Poulperino/KRTEK_V2/POWER_BOARD/POWER_BOARD.pdf

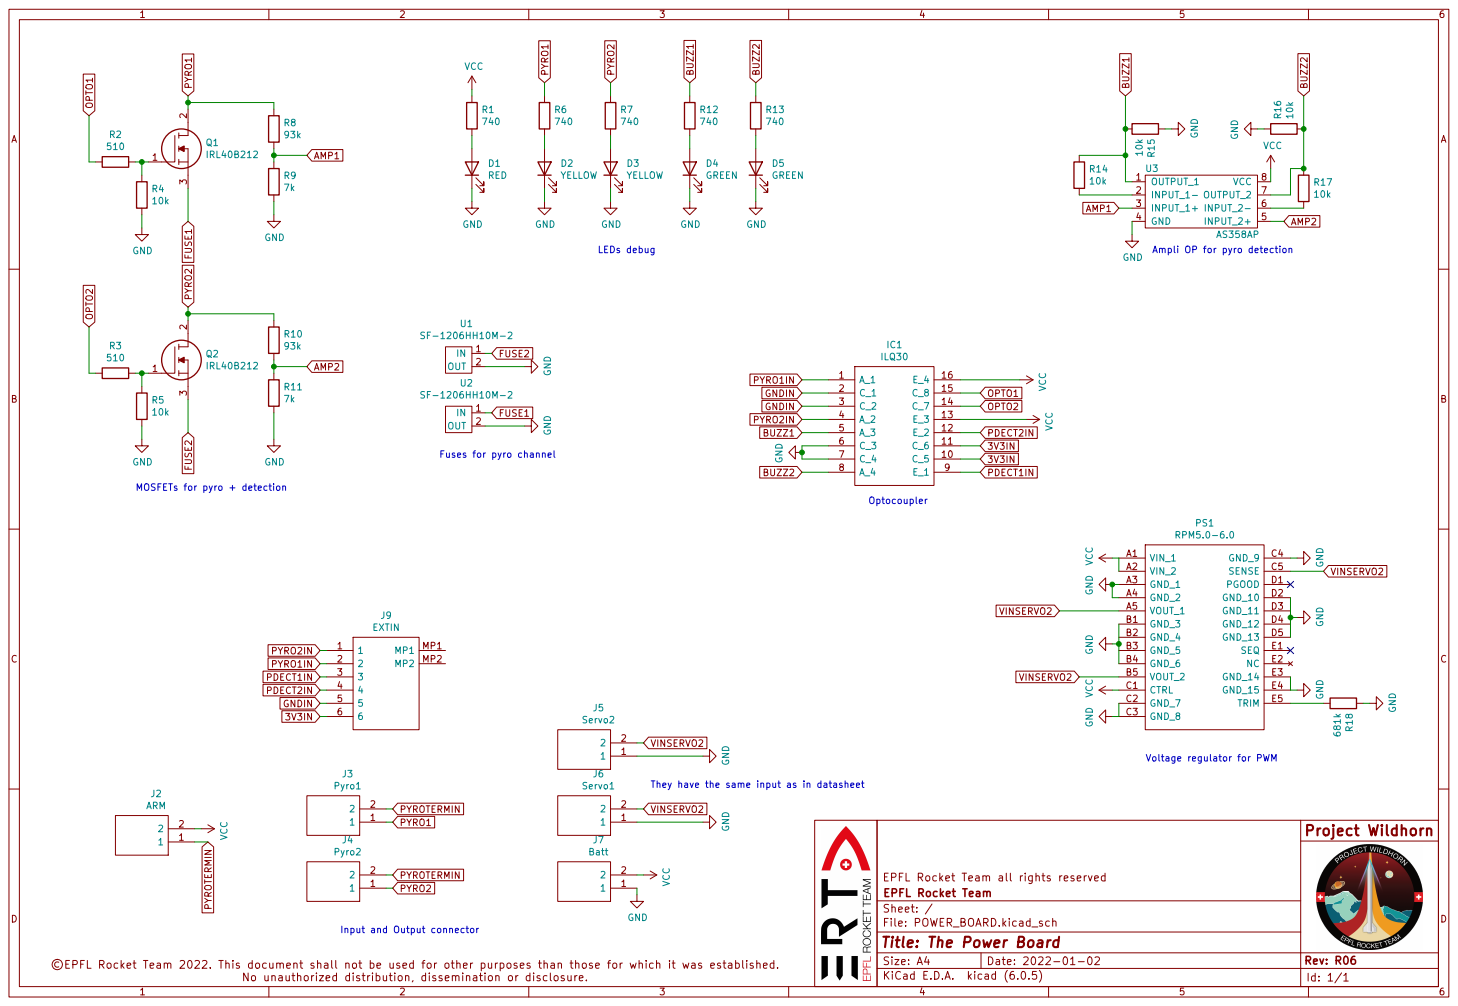
[picture p1: page 1]

VCC GND GND VCC GND

Ampli OP for pyro detection

Fuses for pyro channel

MOSFETs for pyro + detection

Voltage regulator for PWM

EPFL Rocket Team all rights reserved
File: POWER_BOARD.kicad_sch Sheet: / EPFL Rocket Team

Id: 1/1 Title: The Power Board

Input and Output connector
