Poulperino/KRTEK_V2/POWER_BOARD/POWER_BOARD.kicad_pcb

## KiCad design POWER_BOARD/POWER_BOARD.kicad_pcb (2022-11-03)

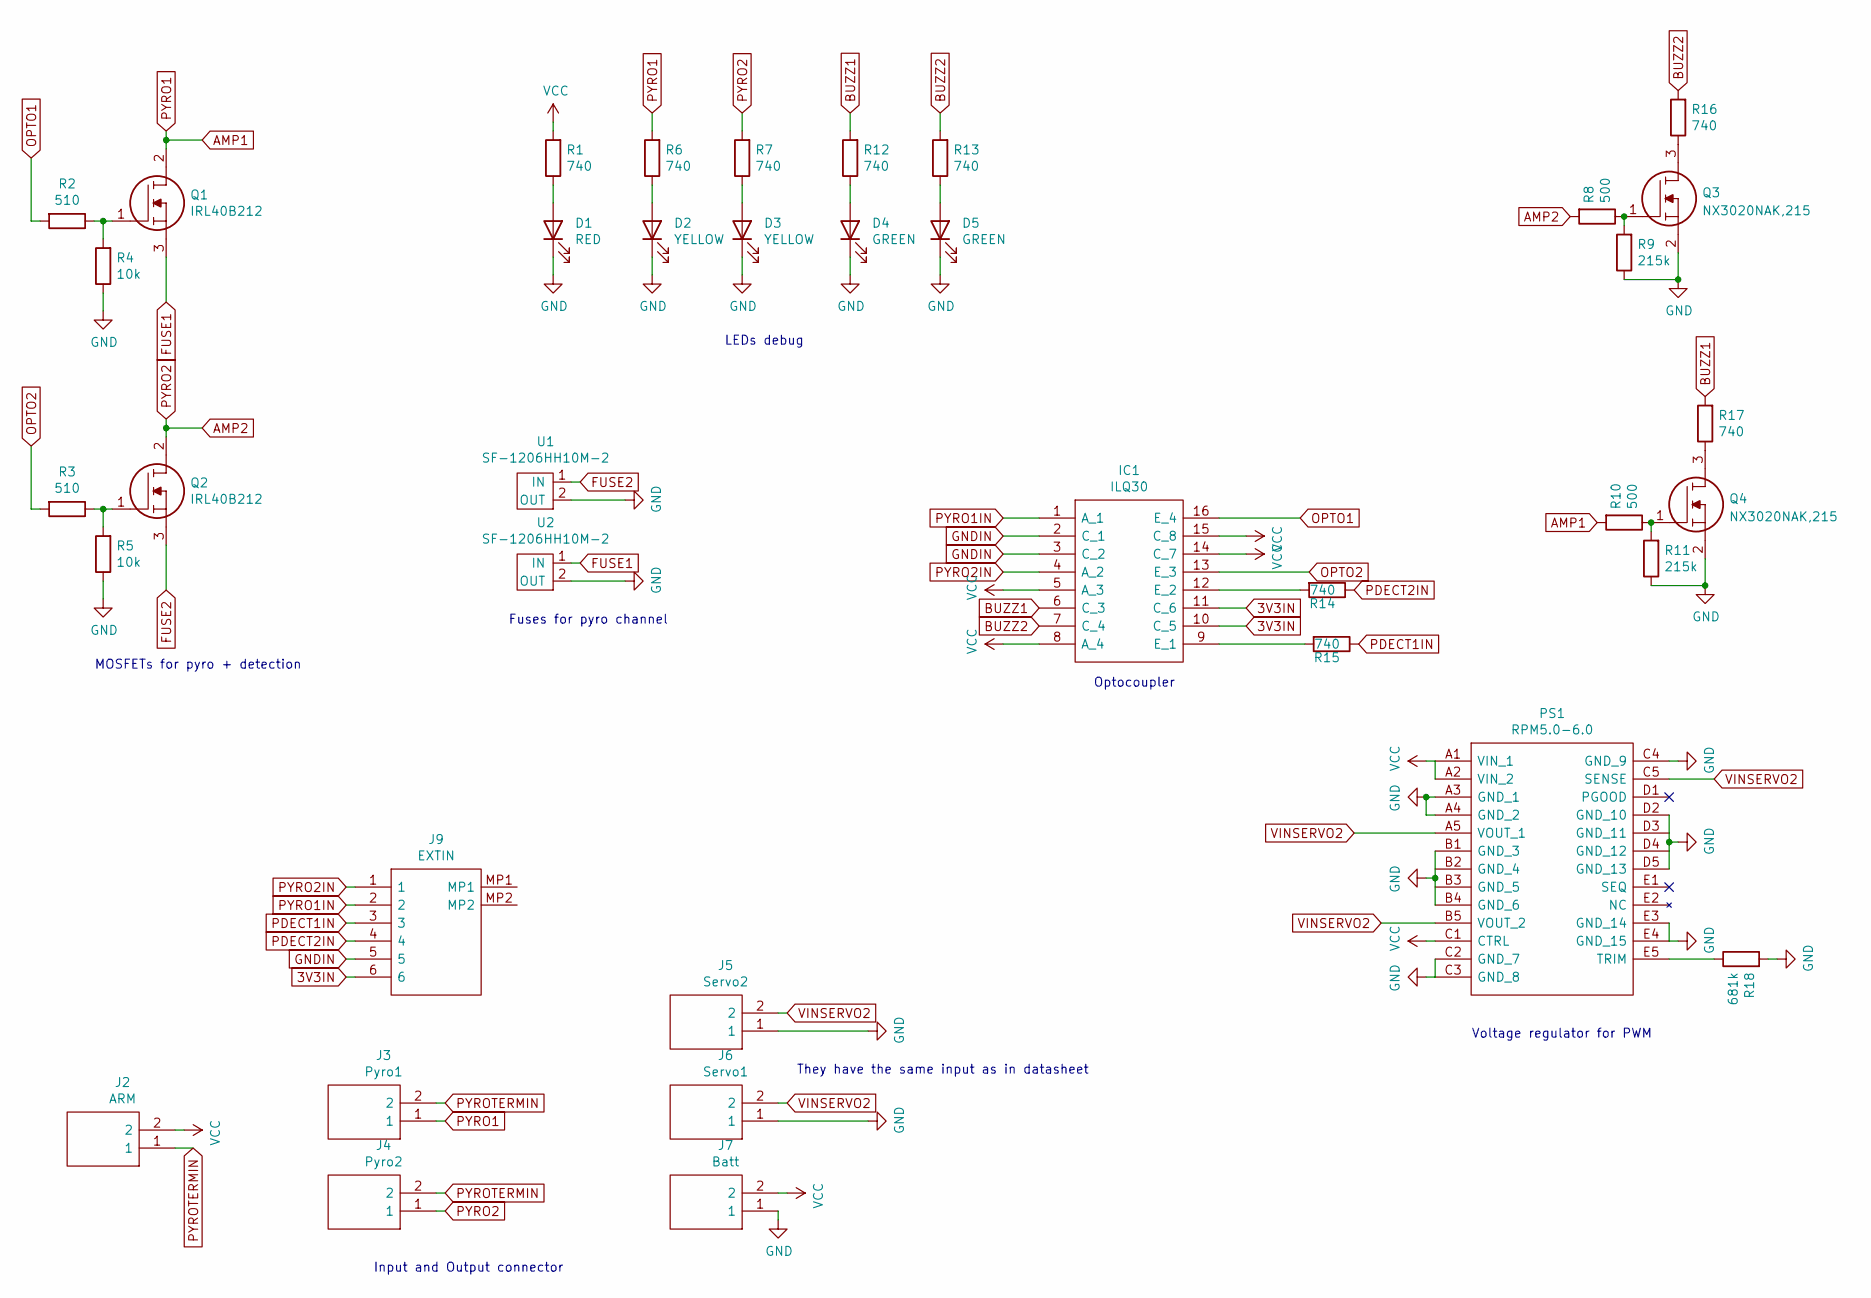
[picture p2: schematic POWER_BOARD.kicad_sch, The Power Board]

Parts:
D1: RED; LED_2-SMD_No_Lead_1.7x0.8mm
D2, D3: YELLOW; LED_2-SMD_No_Lead_1.7x0.8mm
D4, D5: GREEN; LED_2-SMD_No_Lead_1.7x0.8mm
IC1: ILQ30; DIP762W60P254L2030H430Q16N; Mouser Part Number 782-ILQ30
J2: ARM; 282834-2_1; Mouser Part Number 571-282834-2
J3: Pyro1; 282834-2_1; Mouser Part Number 571-282834-2
J4: Pyro2; 282834-2_1; Mouser Part Number 571-282834-2
J5: Servo2; 282834-2_1; Mouser Part Number 571-282834-2
J6: Servo1; 282834-2_1; Mouser Part Number 571-282834-2
J7: Batt; 282834-2_1; Mouser Part Number 571-282834-2
J9: EXTIN; 5055670671; Mouser Part Number 538-505567-0671
PS1: RPM5.0-6.0; RPM5060; Mouser Part Number 919-RPM5.0-6.0
Q1, Q2: IRL40B212; TO254P483X1016X1994-3P; Mouser Part Number 942-IRL40B212
Q3, Q4: NX3020NAK,215; SOT-23; Mouser Part Number 942-IRL40B212
R1, R6, R7, R12, R13, R14, R15, R16, R17: 740; R_0603_1608Metric
R2, R3: 510; R_0603_1608Metric
R4, R5: 10k; R_0603_1608Metric
R8, R10: 500; R_0603_1608Metric
R9, R11: 215k; R_0603_1608Metric
R18: 681k; R_0603_1608Metric
U1, U2: SF-1206HH10M-2

Connections:
3V3IN: IC1.10 (C_5), IC1.11 (C_6), J9.6
AMP1: J3.1, Q1.2, R6.2, R10.2
AMP2: J4.1, Q2.2, R7.2, R8.2
BUZZ1: IC1.6 (C_3), R12.2, R17.2
BUZZ2: IC1.7 (C_4), R13.2, R16.2
FUSE1: Q1.3, U2.1 (IN)
FUSE2: Q2.3, U1.1 (IN)
GND: D1.1 (K), D2.1 (K), D3.1 (K), D4.1 (K), D5.1 (K), J5.1, J6.1, J7.1, PS1.A3 (GND_1), PS1.A4 (GND_2), PS1.B1 (GND_3), PS1.B4 (GND_6), PS1.C2 (GND_7), PS1.C3 (GND_8), PS1.C4 (GND_9), PS1.D2 (GND_10), PS1.D5 (GND_13), PS1.E3 (GND_14), PS1.E4 (GND_15), Q3.2, Q4.2, R4.1, R5.1, R9.1, R11.1, R18.2, U1.2 (OUT), U2.2 (OUT)
GNDIN: IC1.2 (C_1), IC1.3 (C_2), J9.5
unnamed: D1.2 (A), R1.1
unnamed: D2.2 (A), R6.1
unnamed: D3.2 (A), R7.1
unnamed: D4.2 (A), R12.1
unnamed: D5.2 (A), R13.1
unnamed: IC1.9 (E_1), R15.2
unnamed: IC1.12 (E_2), R14.2
unnamed: PS1.E5 (TRIM), R18.1
unnamed: Q1.1, R2.1, R4.2
unnamed: Q2.1, R3.1, R5.2
unnamed: Q3.1, R8.1, R9.2
unnamed: Q3.3, R16.1
unnamed: Q4.1, R10.1, R11.2
unnamed: Q4.3, R17.1
OPTO1: IC1.16 (E_4), R2.2
OPTO2: IC1.13 (E_3), R3.2
PDECT1IN: J9.3, R15.1
PDECT2IN: J9.4, R14.1
PYRO1IN: IC1.1 (A_1), J9.2
PYRO2IN: IC1.4 (A_2), J9.1
PYROTERMIN: J2.1, J3.2, J4.2
VCC: IC1.5 (A_3), IC1.8 (A_4), IC1.14 (C_7), IC1.15 (C_8), J2.2, J7.2, PS1.A1 (VIN_1), PS1.A2 (VIN_2), PS1.C1 (CTRL), R1.2
VINSERVO2: J5.2, J6.2, PS1.A5 (VOUT_1), PS1.B5 (VOUT_2), PS1.C5 (SENSE)

Notes on the sheet:
MOSFETs for pyro + detection
Input and Output connector
LEDs debug
Fuses for pyro channel
Optocoupler
Voltage regulator for PWM
They have the same input as in datasheet

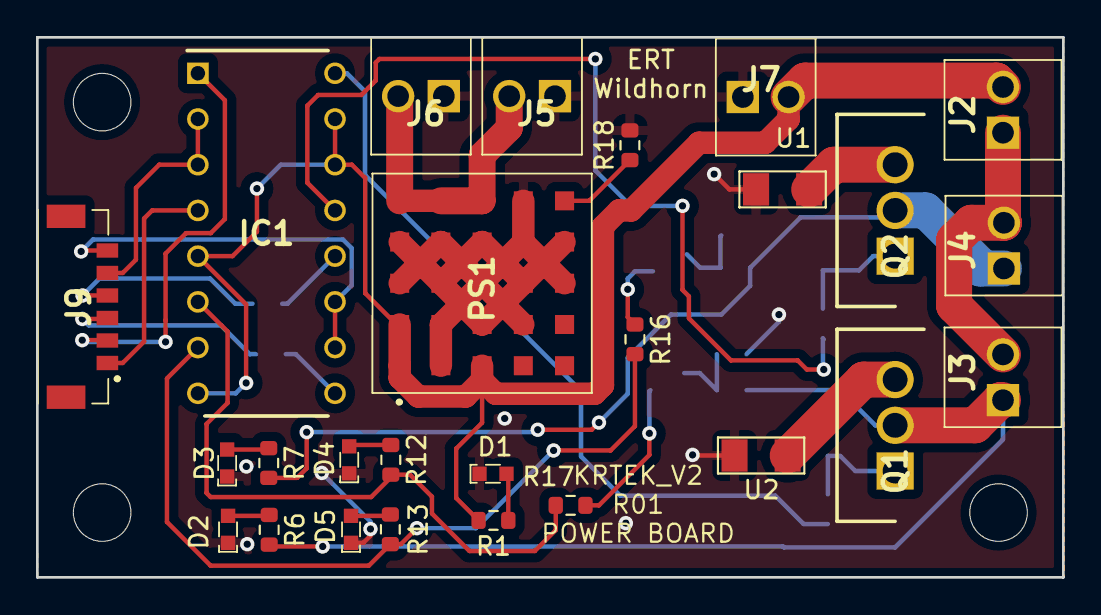
[picture p3: board POWER_BOARD.kicad_pcb from above]

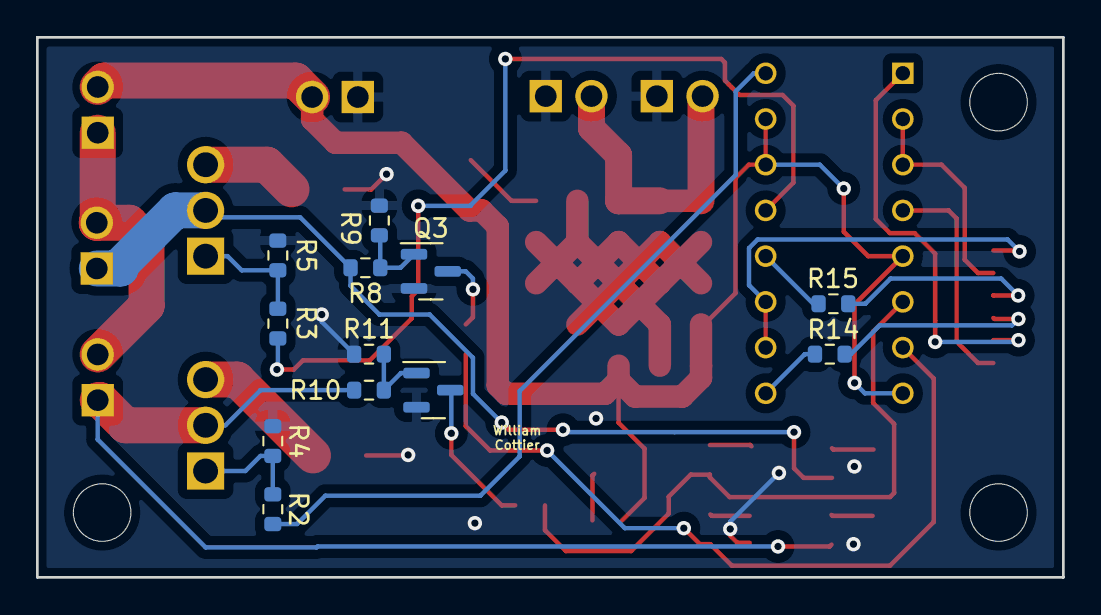
[picture p4: board POWER_BOARD.kicad_pcb from below]

Board: 2 copper layers, 57.0 x 30.0 mm, 38 parts (12 on the bottom side), 32 nets.
