Poulperino/KRTEK_V2/EXTENSION_BOARD/EXTENSION_BOARD.kicad_pcb

## KiCad design EXTENSION_BOARD/EXTENSION_BOARD.kicad_pcb (2022-11-03)

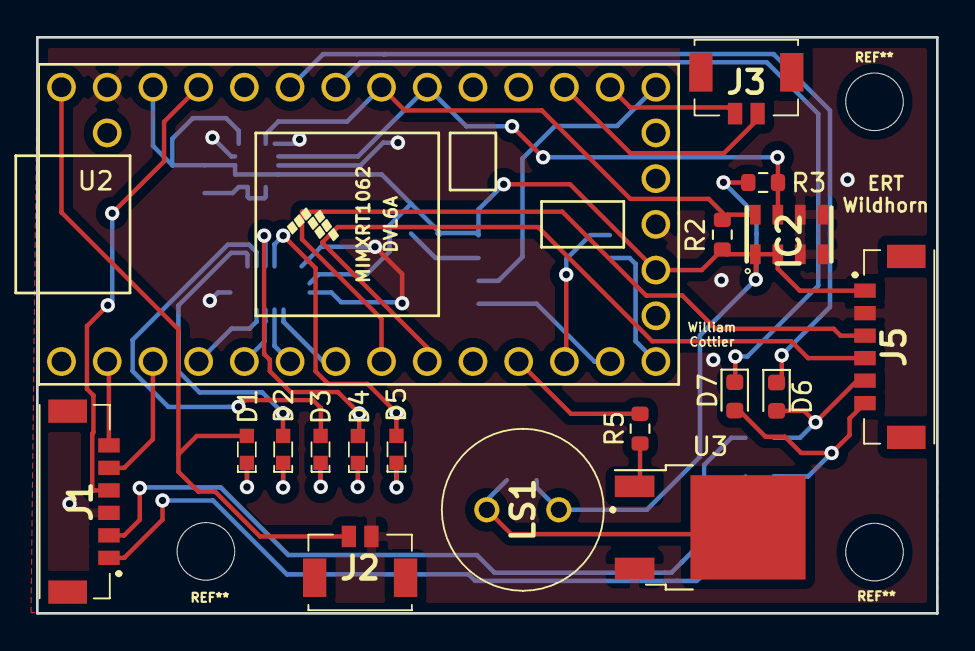
[picture p5: board EXTENSION_BOARD.kicad_pcb from above]

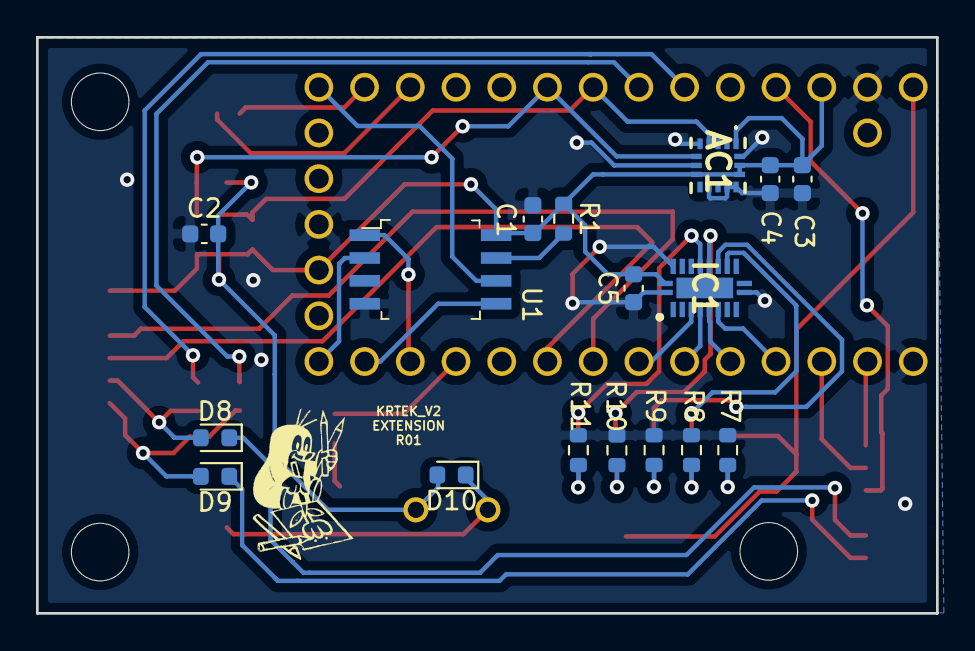
[picture p6: board EXTENSION_BOARD.kicad_pcb from below]

Board: 2 copper layers, 50.0 x 32.0 mm, 35 parts (17 on the bottom side), 39 nets.

Parts:
AC1: Accel - H3LIS331DLTR; LIS3DHTR
C1: 100nF; C_0603_1608Metric
C2, C3, C5: 0.1uF; C_0603_1608Metric
C4: 10uF; C_0603_1608Metric
D1: RED; LED_2-SMD_No_Lead_1.7x0.8mm
D2, D3: YELLOW; LED_2-SMD_No_Lead_1.7x0.8mm
D4, D5: GREEN; LED_2-SMD_No_Lead_1.7x0.8mm
D6, D7, D8, D9, D10: DIODE; D_0603_1608Metric
IC1: TeensyBuffer - 74AHCV541ABQX; QFN50P250X450X100-21N-D
IC2: Baro - MS561101BA03-50; MS561101BA03-50
J1: EXTIN; 5055670671
J2: BATT; 5055670281
J3: PWM; 5055670281
J5: EXTOUT; 5055670671
LS1: Buzzer - CST-931AP; CST931AP
R1: 10M; R_0603_1608Metric
R2, R3: 3.3K; R_0603_1608Metric
R5: 10k; R_0603_1608Metric
R7: 500; R_0603_1608Metric
R8, R9, R10, R11: 330; R_0603_1608Metric
U1: Flash - COM-15809; SOIC-8_W5.6mm
U2: Teensy4.0; Teensy40_EXT
U3: MJD148J; TO-252-2

Connections:
+3V3: AC1.1, AC1.8, AC1.14, AC1.15, C1.1, C2.2, C3.1, C4.1, C5.2, D10.2, IC1.20, IC2.1, IC2.2, J5.1, LS1.1, R1.1, R2.2, R3.2, U1.8, U2.16, U2.31
Accel_SCL: AC1.4, IC2.8, R2.1, U2.26
Accel_SDA: AC1.6, IC2.7, R3.1, U2.25
Buzzer: D10.1, LS1.2, U3.2
CS_FLASH: U1.1, U2.12
GLED1: D4.2, IC1.15
GLED2: D5.2, IC1.16
GND: AC1.5, AC1.7, AC1.10, AC1.12, AC1.13, AC1.16, C1.2, C2.1, C3.2, C4.2, C5.1, IC1.1, IC1.10, IC1.19, IC2.3, IC2.4, IC2.5, IC2.6, J1.3, J2.2, J5.2, R7.1, R8.1, R9.1, R10.1, R11.1, U1.4, U2.1, U2.17, U2.32, U3.3
HFREE: J1.4, U2.30
HRX: J1.6, U2.2
HTX: J1.5, U2.3
MISO: U1.2, U2.14
MOSI: U1.5, U2.13
unnamed: D1.1, R7.2
unnamed: D2.1, R8.2
unnamed: D3.1, R9.2
unnamed: D4.1, R10.2
unnamed: D5.1, R11.2
unnamed: R1.2, U1.7
unnamed: R5.1, U3.1
OPYRO1: D6.2, D8.2, J5.5
OPYRO2: D7.2, D9.2, J5.6
PDECT1: J5.3, U2.8
PDECT2: J5.4, U2.9
PWM1: J3.2, U2.21
PWM2: J3.1, U2.22
PYRO1: D8.1, J1.2
PYRO2: D9.1, J1.1
SCLK: U1.6, U2.20
TBuzzer: R5.2, U2.11
TGLED1: IC1.5, U2.6
TGLED2: IC1.4, U2.7
TPyro1OUT: D6.1, U2.28
TPyro2OUT: D7.1, U2.27
TYLED1: IC1.7, U2.4
TYLED2: IC1.6, U2.5
VIN: D1.2, J2.1, U2.33
YLED1: D2.2, IC1.13
YLED2: D3.2, IC1.14
