Poulperino/KRTEK_V2/CLIP_HOSTBOARD/CLIP_HOSTBOARD.kicad_pcb

## KiCad design CLIP_HOSTBOARD/CLIP_HOSTBOARD.kicad_pcb (2021-12-23)

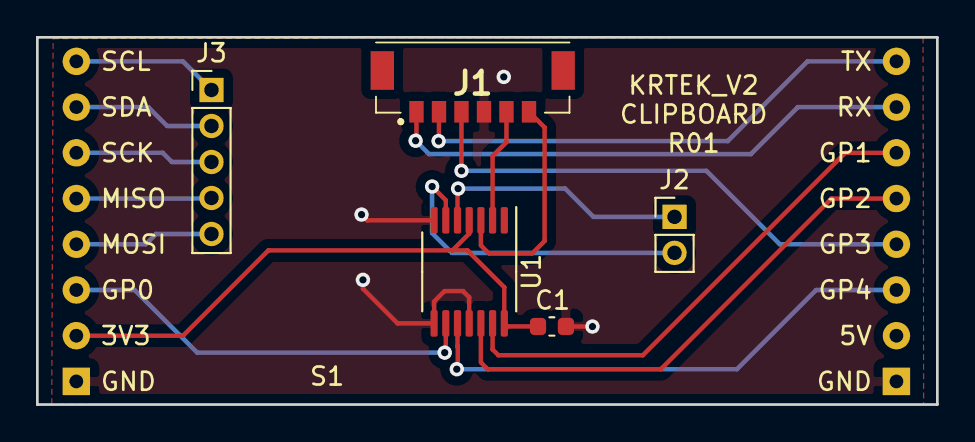
[picture p7: board CLIP_HOSTBOARD.kicad_pcb from above]

Board: 2 copper layers, 50.0 x 20.4 mm, 6 parts (0 on the bottom side), 18 nets.

Parts:
C1: 0.1uF; C_0603_1608Metric
J1: 505567-0671; 5055670671
J2: 1x2_header; PinHeader_1x02_P2.00mm_Vertical
J3: 1x5_header; PinHeader_1x05_P2.00mm_Vertical
S1: Socket; SOCKET
U1: Buffer; TSSOP-14_4.4x5mm_P0.65mm

Connections:
3V3: C1.2, S1.7, U1.4, U1.14
BFREEIN1: S1.11, U1.10
BFREEIN2: S1.6, U1.9
BFREEOUT1: J2.1, U1.5
BFREEOUT2: J2.2, U1.6
GND: C1.1, J1.4, S1.8, S1.9, U1.7, U1.8, U1.11
HFREE: J1.3, S1.12
HPYRO1: S1.14, U1.13
HPYRO2: S1.13, U1.12
HRX: J1.1, S1.15
HTX: J1.2, S1.16
MISOFREE: J3.4, S1.4
MOSIFREE: J3.5, S1.5
PYRO1: J1.5, U1.2
PYRO2: J1.6, U1.3
SCKFREE: J3.3, S1.3
SCLFREE: J3.1, S1.1
SDAFREE: J3.2, S1.2
