Poulperino/KRTEK_V2/POWER_BOARD/V05_POWER_BOARD.kicad_pcb

## KiCad design POWER_BOARD/V05_POWER_BOARD.kicad_pcb (2021-11-19)

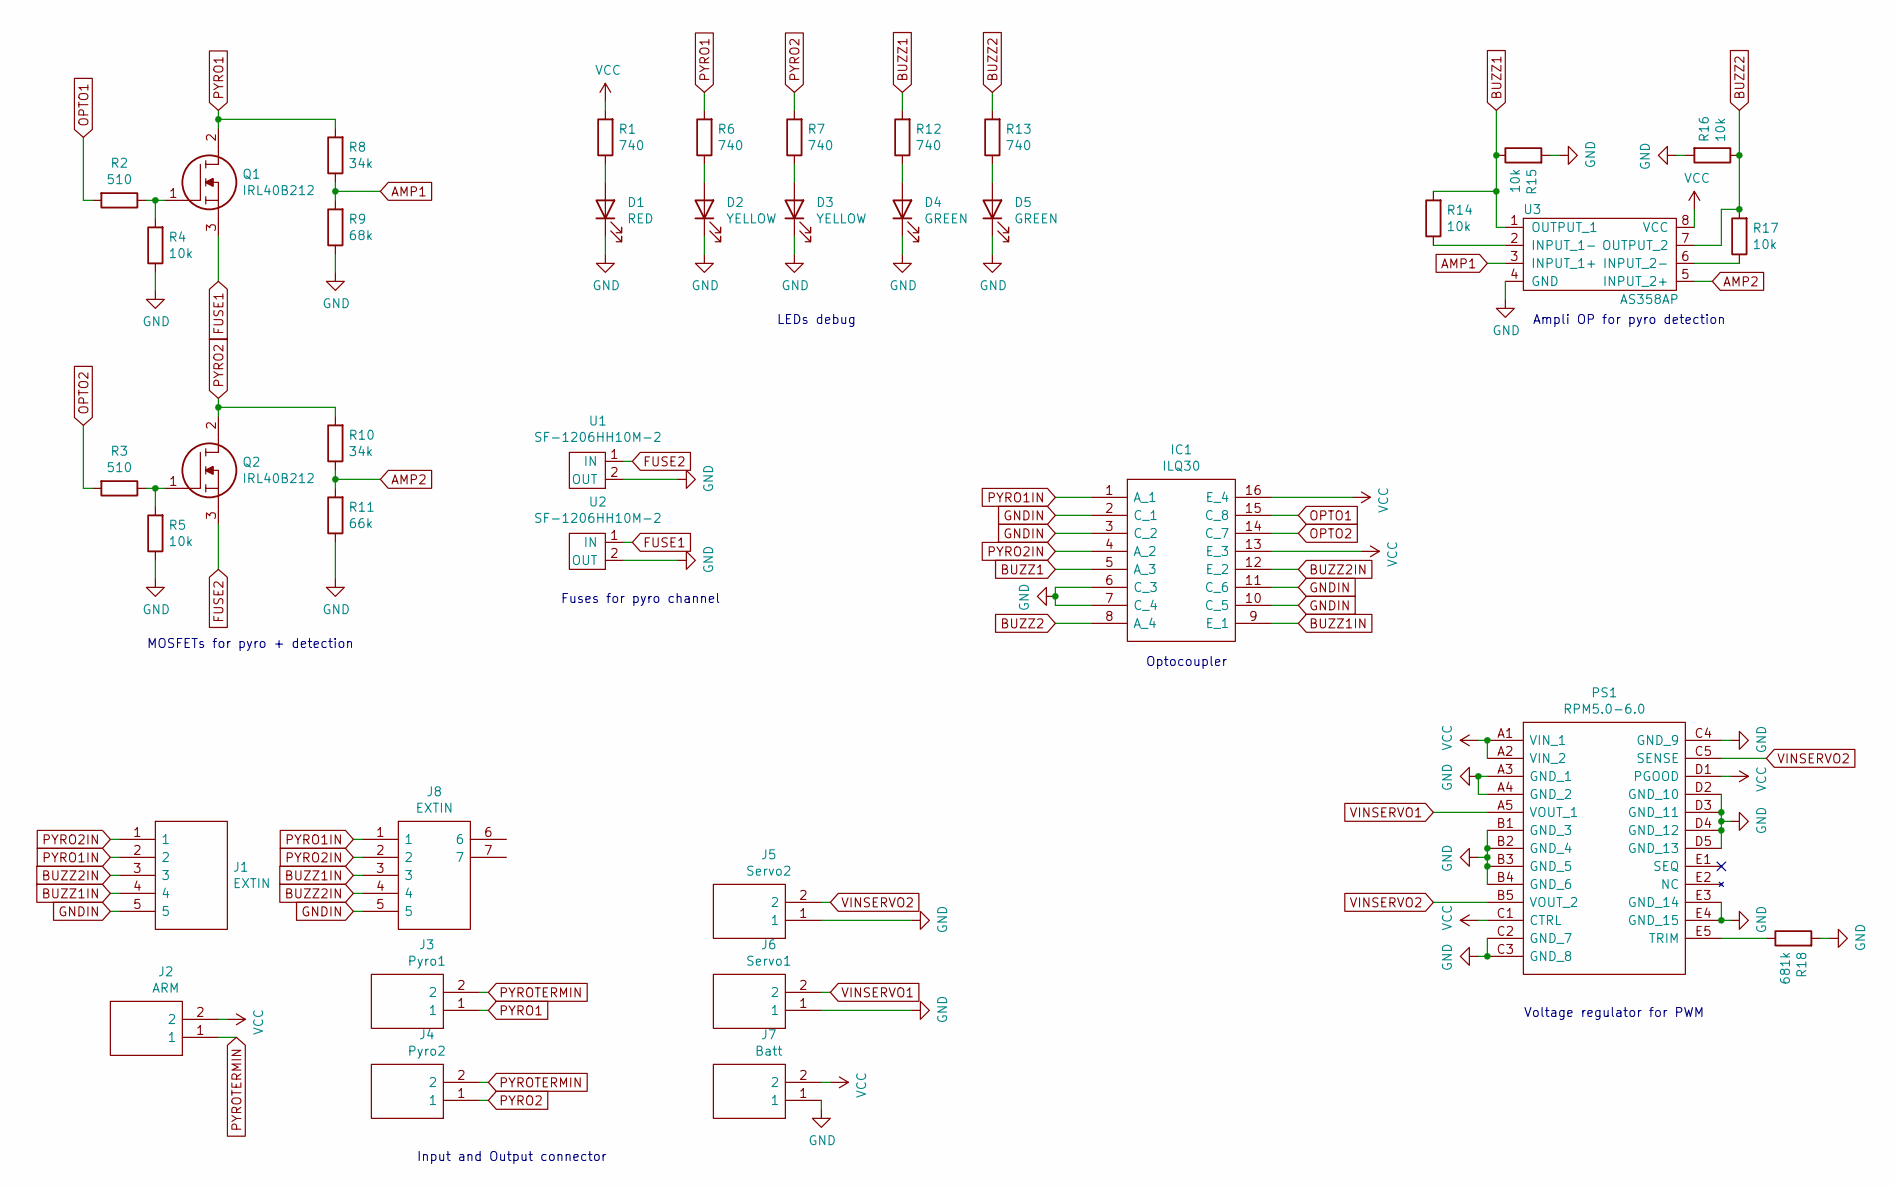
[picture p8: schematic V05_POWER_BOARD.sch]

Parts:
D1: RED; LED_2-SMD_No_Lead_1.7x0.8mm
D2, D3: YELLOW; LED_2-SMD_No_Lead_1.7x0.8mm
D4, D5: GREEN; LED_2-SMD_No_Lead_1.7x0.8mm
IC1: ILQ30; DIP762W60P254L2030H430Q16N; Mouser Part Number 782-ILQ30
J1: EXTIN; 2828345; Mouser Part Number 571-282834-5
J2: ARM; 282834-2_1; Mouser Part Number 571-282834-2
J3: Pyro1; 282834-2_1; Mouser Part Number 571-282834-2
J4: Pyro2; 282834-2_1; Mouser Part Number 571-282834-2
J5: Servo2; 282834-2_1; Mouser Part Number 571-282834-2
J6: Servo1; 282834-2_1; Mouser Part Number 571-282834-2
J7: Batt; 282834-2_1; Mouser Part Number 571-282834-2
J8: EXTIN; 5055670571; Mouser Part Number 538-505567-0571
PS1: RPM5.0-6.0; RPM5060; Mouser Part Number 919-RPM5.0-6.0
Q1, Q2: IRL40B212; TO254P483X1016X1994-3P; Mouser Part Number 942-IRL40B212
R1, R6, R7, R12, R13: 740; R_0603_1608Metric
R2, R3: 510; R_0603_1608Metric
R4, R5, R14, R15, R16, R17: 10k; R_0603_1608Metric
R8, R10: 34k; R_0603_1608Metric
R9: 68k; R_0603_1608Metric
R11: 66k; R_0603_1608Metric
R18: 681k; R_0603_1608Metric
U1, U2: SF-1206HH10M-2
U3: AS358AP; AS358AP-PDIP-8

Connections:
AMP1: R8.1, R9.2, U3.3 (INPUT_1+)
AMP2: R10.1, R11.2, U3.5 (INPUT_2+)
BUZZ1: IC1.5 (A_3), R12.2, R14.2, R15.1, U3.1 (OUTPUT_1)
BUZZ1IN: IC1.9 (E_1), J1.4, J8.3
BUZZ2: IC1.8 (A_4), R13.2, R16.1, R17.2, U3.7 (OUTPUT_2)
BUZZ2IN: IC1.12 (E_2), J1.3, J8.4
FUSE1: Q1.3, U2.1 (IN)
FUSE2: Q2.3, U1.1 (IN)
GND: D1.1 (K), D2.1 (K), D3.1 (K), D4.1 (K), D5.1 (K), IC1.6 (C_3), IC1.7 (C_4), J5.1, J6.1, J7.1, PS1.A3 (GND_1), PS1.A4 (GND_2), PS1.B1 (GND_3), PS1.B2 (GND_4), PS1.B3 (GND_5), PS1.B4 (GND_6), PS1.C2 (GND_7), PS1.C3 (GND_8), PS1.C4 (GND_9), PS1.D2 (GND_10), PS1.D3 (GND_11), PS1.D4 (GND_12), PS1.D5 (GND_13), PS1.E3 (GND_14), PS1.E4 (GND_15), R4.1, R5.1, R9.1, R11.1, R15.2, R16.2, R18.2, U1.2 (OUT), U2.2 (OUT), U3.4 (GND)
GNDIN: IC1.2 (C_1), IC1.3 (C_2), IC1.10 (C_5), IC1.11 (C_6), J1.5, J8.5
unnamed: D1.2 (A), R1.1
unnamed: D2.2 (A), R6.1
unnamed: D3.2 (A), R7.1
unnamed: D4.2 (A), R12.1
unnamed: D5.2 (A), R13.1
unnamed: PS1.E5 (TRIM), R18.1
unnamed: Q1.1, R2.1, R4.2
unnamed: Q2.1, R3.1, R5.2
unnamed: R14.1, U3.2 (INPUT_1-)
unnamed: R17.1, U3.6 (INPUT_2-)
OPTO1: IC1.15 (C_8), R2.2
OPTO2: IC1.14 (C_7), R3.2
PYRO1: J3.1, Q1.2, R6.2, R8.2
PYRO1IN: IC1.1 (A_1), J1.2, J8.1
PYRO2: J4.1, Q2.2, R7.2, R10.2
PYRO2IN: IC1.4 (A_2), J1.1, J8.2
PYROTERMIN: J2.1, J3.2, J4.2
VCC: IC1.13 (E_3), IC1.16 (E_4), J2.2, J7.2, PS1.A1 (VIN_1), PS1.A2 (VIN_2), PS1.C1 (CTRL), PS1.D1 (PGOOD), R1.2, U3.8 (VCC)
VINSERVO1: J6.2, PS1.A5 (VOUT_1)
VINSERVO2: J5.2, PS1.B5 (VOUT_2), PS1.C5 (SENSE)

Notes on the sheet:
LEDs debug
MOSFETs for pyro + detection
Fuses for pyro channel
Input and Output connector
Voltage regulator for PWM
Optocoupler
Ampli OP for pyro detection

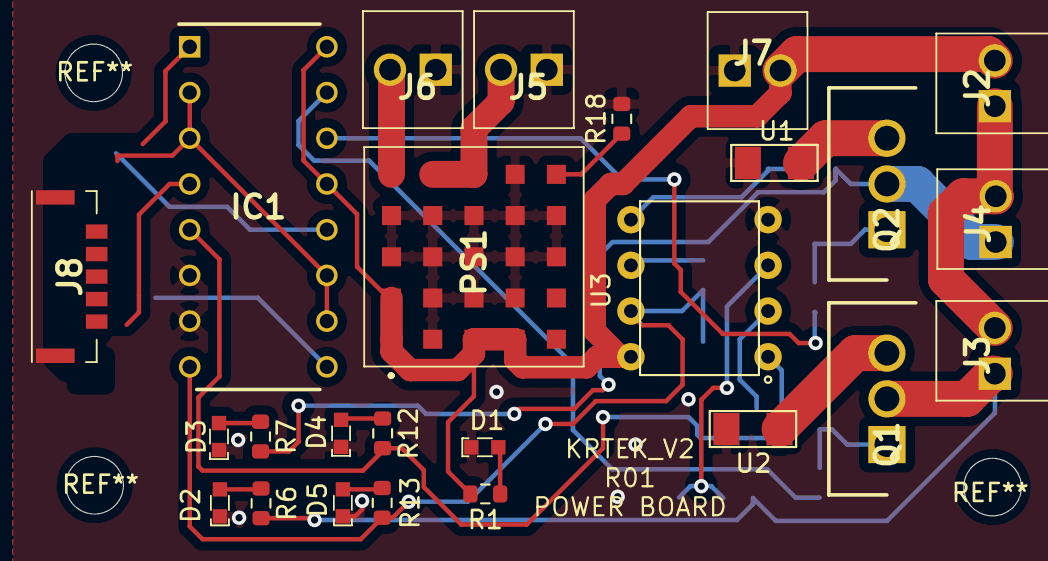
[picture p9: board V05_POWER_BOARD.kicad_pcb from above]

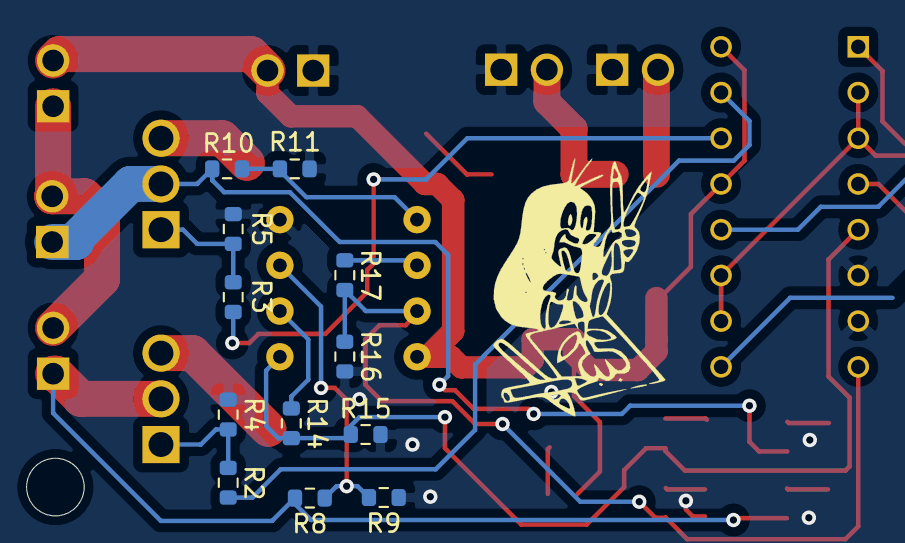
[picture p10: board V05_POWER_BOARD.kicad_pcb from below]

Board: 2 copper layers, 37 parts (12 on the bottom side), 30 nets.
