Poulperino/KRTEK_V2/EXTENSION_BOARD/V02_EXTENSION_BOARD.kicad_pcb

## KiCad design EXTENSION_BOARD/V02_EXTENSION_BOARD.kicad_pcb (2021-11-12, an earlier design)

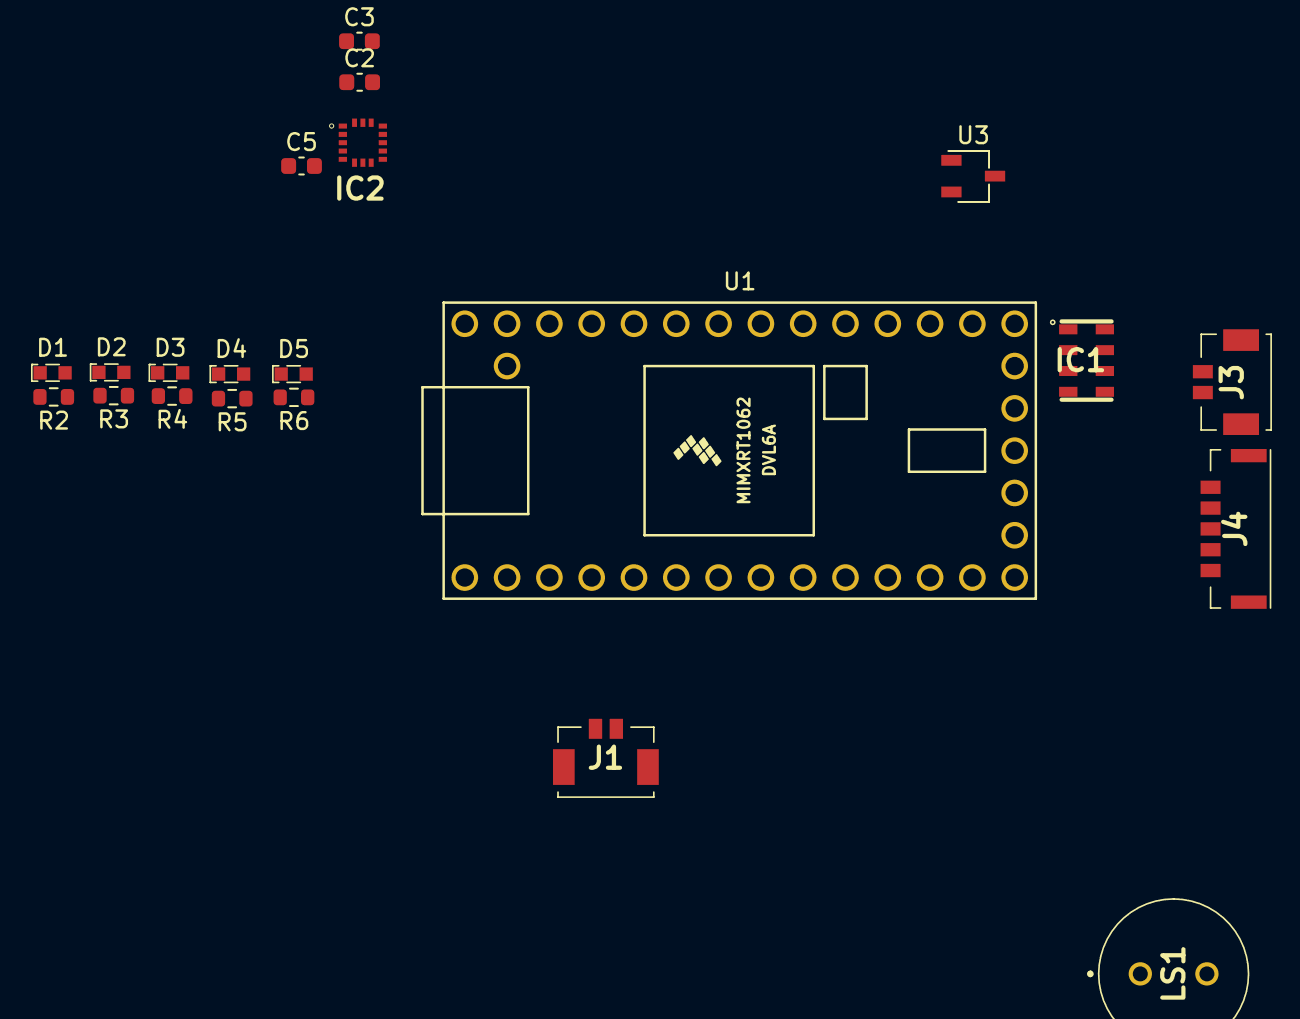
[picture p11: board V02_EXTENSION_BOARD.kicad_pcb from above]

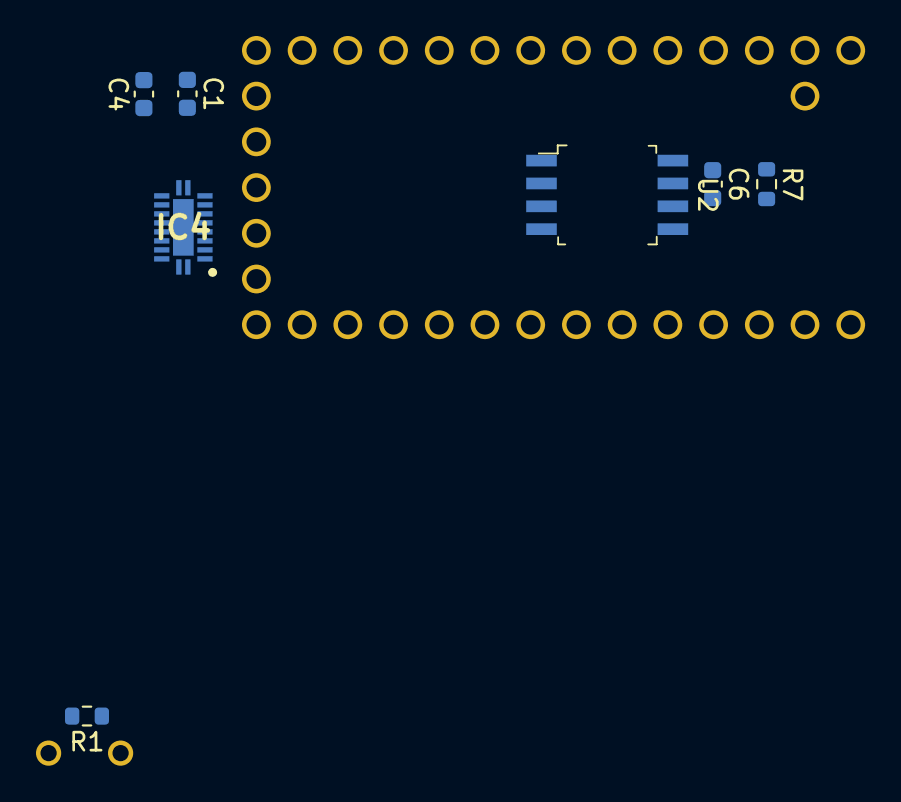
[picture p12: board V02_EXTENSION_BOARD.kicad_pcb from below]

Board: 2 copper layers, 28 parts (7 on the bottom side), 25 nets, no tracks yet.

Parts:
C1: 100nF; C_0603_1608Metric
C2: 0.1uF; C_0603_1608Metric
C3: 10nF; C_0603_1608Metric
C4: 2.2uF; C_0603_1608Metric
C5: 0.47uF; C_0603_1608Metric
C6: 22pF; C_0603_1608Metric
D1: RED; LED_2-SMD_No_Lead_1.7x0.8mm
D2, D3: YELLOW; LED_2-SMD_No_Lead_1.7x0.8mm
D4, D5: GREEN; LED_2-SMD_No_Lead_1.7x0.8mm
IC1: Baro; MS561101BA03-50
IC2: ICM-20608-G; PULL-BACK-QFN-16
IC4: TeensyBuffer; QFN50P250X450X100-21N-D
J1: BATT; 5055670281
J3: PWM; 5055670281
J4: EXTOUT; 5055670571
LS1: Buzzer; CST931AP
R1: 1k; R_0603_1608Metric
R2: 740; R_0603_1608Metric
R3, R4, R5, R6: 330; R_0603_1608Metric
R7: 10M; R_0603_1608Metric
U1: Teensy4.0; Teensy40_EXT
U2: COM-15809; SOIC-8_W5.6mm
U3: MOSBuzzer; TSOT-23

Connections:
3V3: C1.2, C2.1, C3.1, C4.1, C6.1, IC1.1, IC2.1, IC2.16, R7.1, U1.16, U1.31, U2.8, U3.3
BUZZ1: IC4.14, J4.3
BUZZ2: IC4.13, J4.4
Buzzer: LS1.1, R1.1, U3.2
GLED1: D4.2, IC4.16
GLED2: D5.2, IC4.15
GND: C1.1, C2.2, C3.2, C4.2, C5.1, C6.2, IC1.2, IC1.3, IC2.9, IC2.10, IC2.11, IC2.12, IC2.13, IC2.15, IC4.1, IC4.10, IC4.19, J1.1, J4.5, LS1.2, R1.2, R2.1, R3.1, R4.1, R5.1, R6.1, U1.1, U1.17, U1.32, U2.4
MISO: IC1.6, U2.2
MOSI: IC1.7, U2.5
unnamed: C5.2, IC2.14
unnamed: D1.1, R2.2
unnamed: D2.1, R3.2
unnamed: D3.1, R4.2
unnamed: D4.1, R5.2
unnamed: D5.1, R6.2
unnamed: R7.2, U2.7
SCLK: IC1.8, IC2.2, U2.6
TBuzzer: U1.8, U3.1
TGLED1: IC4.4, U1.6
TGLED2: IC4.5, U1.7
TYLED1: IC4.2, U1.4
TYLED2: IC4.3, U1.5
VIN: IC4.20, J1.2, U1.33
YLED1: D2.2, IC4.18
YLED2: D3.2, IC4.17
