Poulperino/KRTEK_V2/(commit log)

2021-11-09 Update POWER_BOARD.sch-bak
2021-11-09 Update EXTENSION_BOARD.kicad_pcb-bak
2021-11-15 Worked again
    [EXTENSION_BOARD.kicad_pcb, EXTENSION_BOARD.sch, POWER_BOARD.kicad_pcb, POWER_BOARD.sch, V03_EXTENSION_BOARD.kicad_pcb, V03_EXTENSION_BOARD.sch, V04_EXTENSION_BOARD.sch]
2021-11-19 Sent schematics to review
    [CLIP_HOSTBOARD.kicad_pcb, CLIP_HOSTBOARD.sch, EXTENSION_BOARD.kicad_pcb, EXTENSION_BOARD.sch, POWER_BOARD.sch, Screenshots_EXTENSION_BOARD.sch]
2021-11-25 last changes
    [CLIP_HOSTBOARD.kicad_pcb, CLIP_HOSTBOARD.sch, EXTENSION_BOARD.kicad_pcb, EXTENSION_BOARD.sch, POWER_BOARD.kicad_pcb]
2021-12-23 Update soft
    [CLIP_HOSTBOARD.kicad_pcb]
2022-11-03 last commit
    [EXTENSION_BOARD.kicad_pcb, POWER_BOARD.kicad_pcb]
2022-11-03 real last commit
    [CLIP_HOSTBOARD.kicad_sch, EXTENSION_BOARD.kicad_sch, POWER_BOARD.csv, POWER_BOARD.kicad_sch]
